tomwimmenhove/NoPullShit/cad/drawings/battery/ec0159ee7147ed0261.jpg

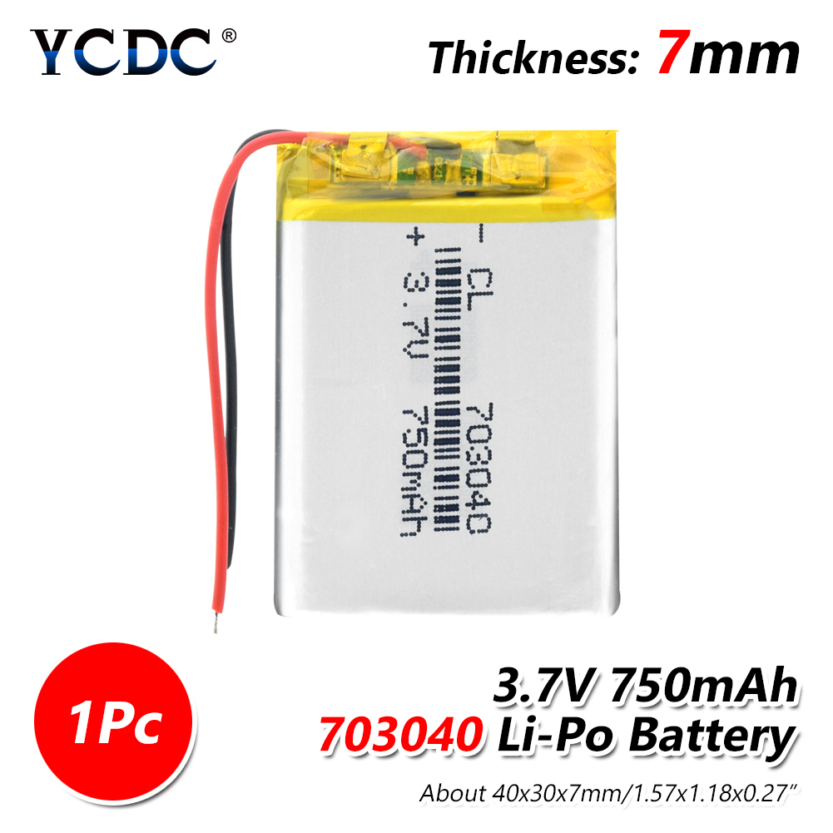
cad/drawings/battery/ec0159ee7147ed0261.jpg
