tomwimmenhove/NoPullShit/cad/drawings/speaker/s-l500.png

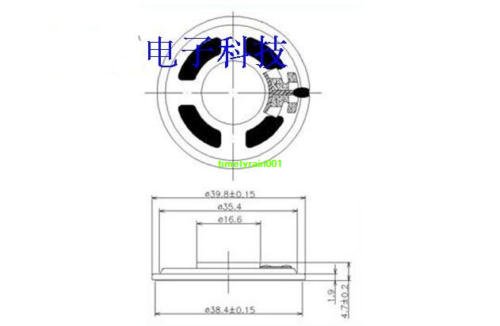
cad/drawings/speaker/s-l500.png
