tomwimmenhove/NoPullShit/cad/NoPullShit.FCStd

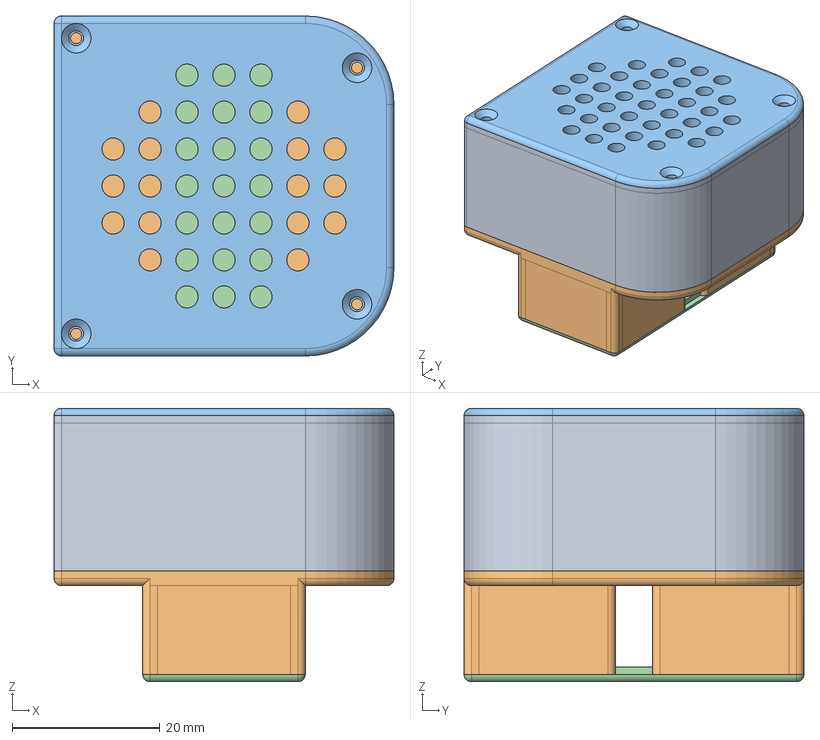
[picture p3: CAD file, 2021-06-24]
cad/NoPullShit.FCStd
46.0 x 46.0 x 37.0 mm
TopSection
BottomSection
TopCover
BottomCover
