tomwimmenhove/NoPullShit/cad/models/10103594-0001LF/10103594.stp

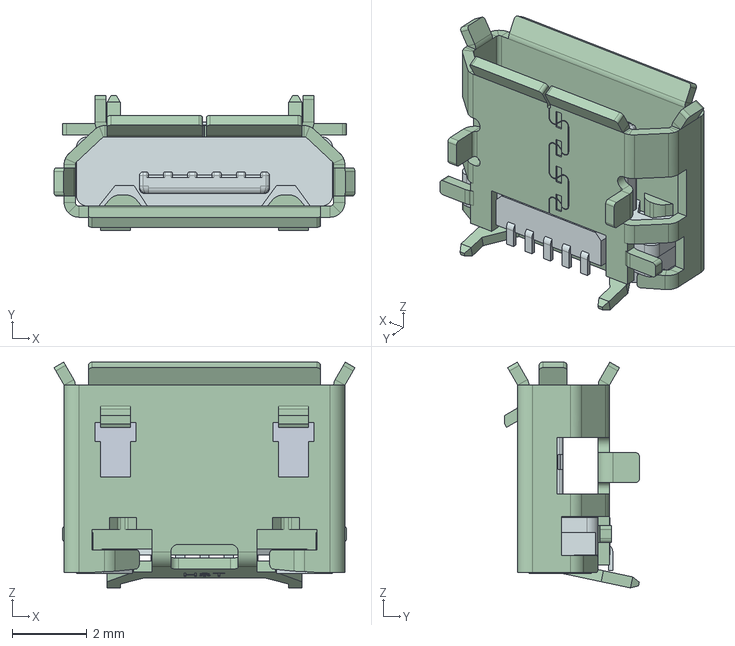
[picture p4: CAD file, 2021-06-19]
cad/models/10103594-0001LF/10103594.stp
8.04 x 3.60 x 6.03 mm
