tomwimmenhove/NoPullShit/hardware/NoPullShit/NoPullShit.kicad_pcb

## KiCad design hardware/NoPullShit/NoPullShit.kicad_pcb (2021-06-08)

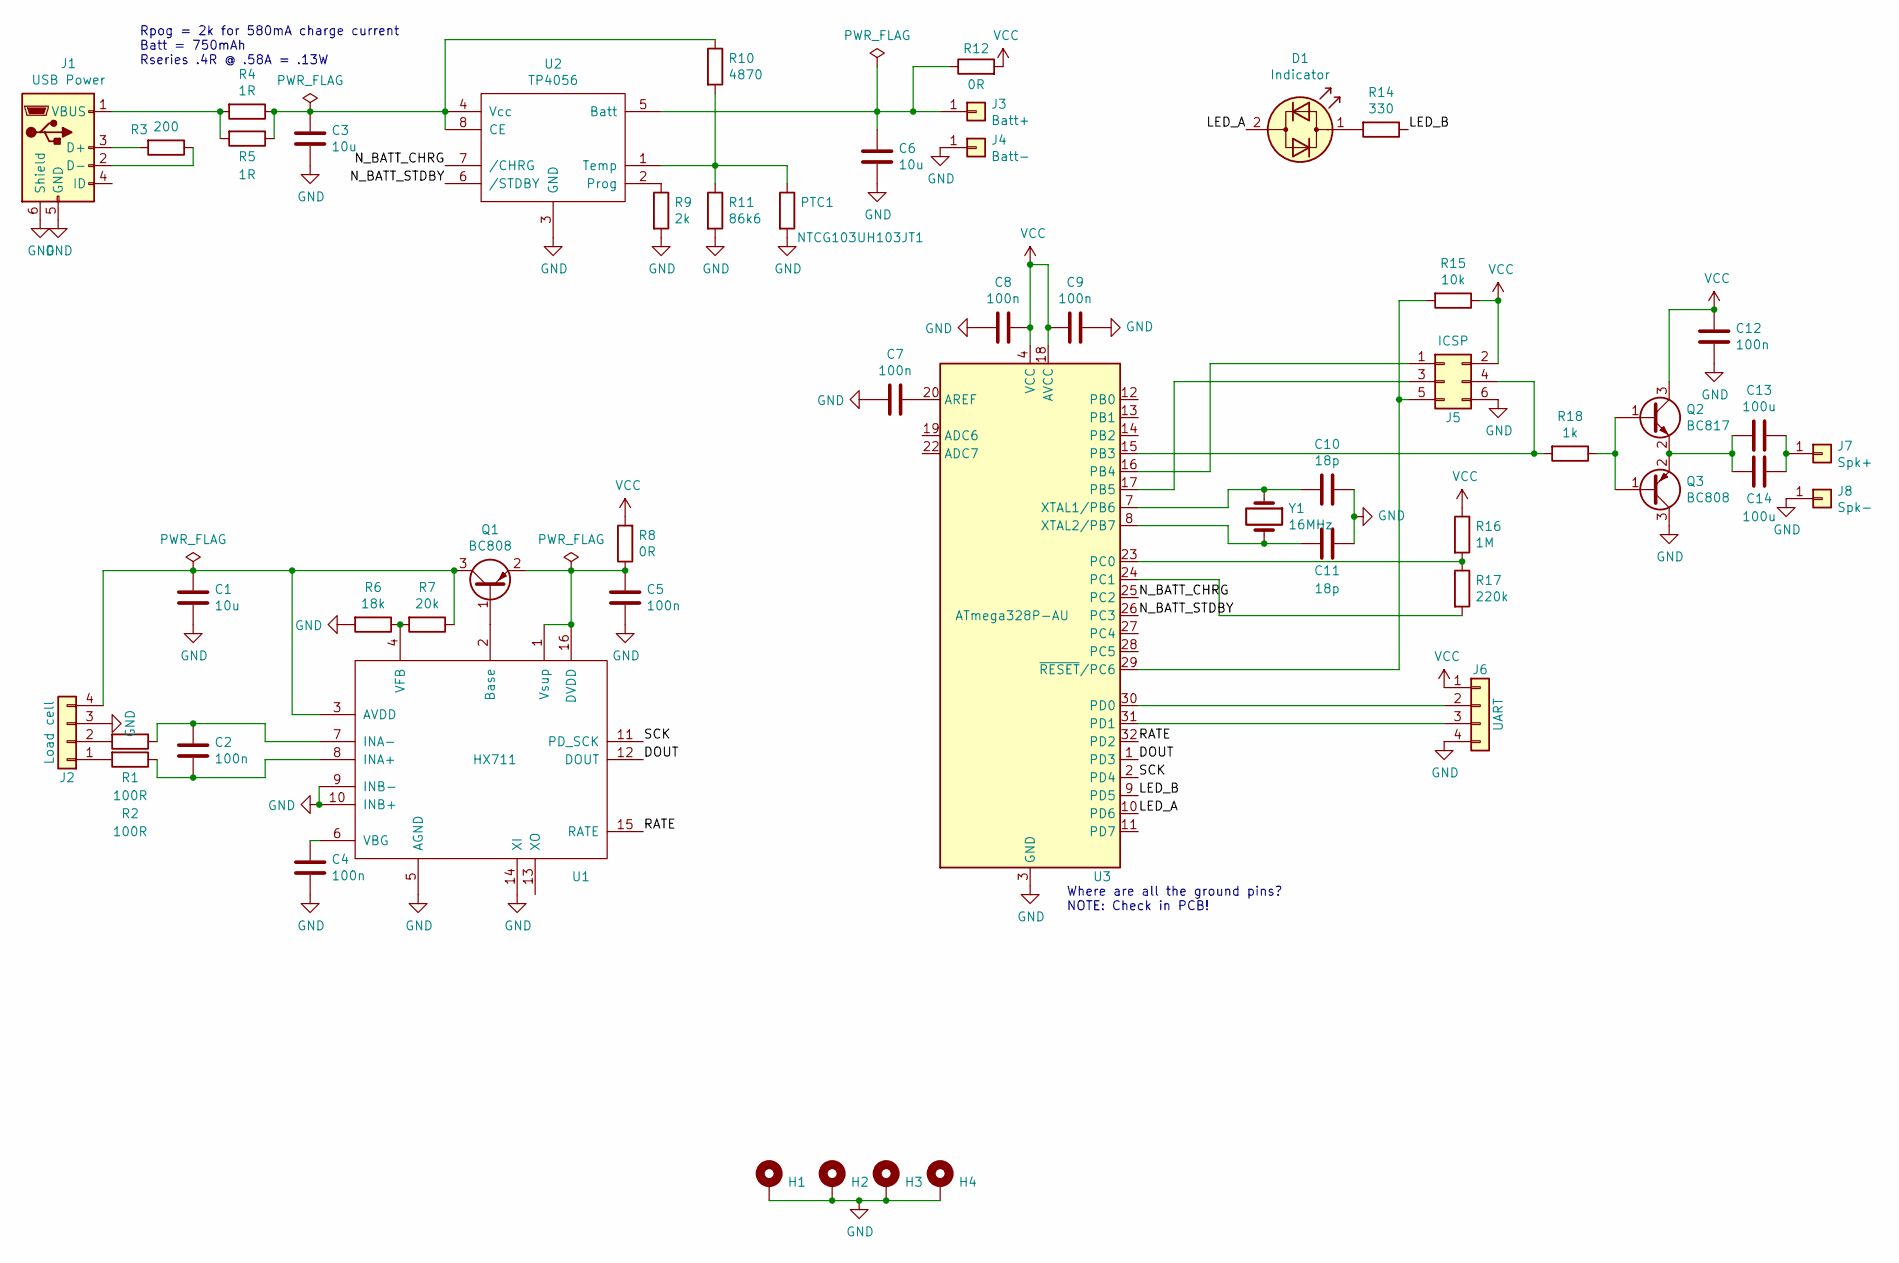
[picture p5: schematic NoPullShit.sch]

Parts:
C1, C3, C6: 10u; C_0805_2012Metric
C2, C4, C5, C7, C8, C9, C12: 100n; C_0603_1608Metric
C10, C11: 18p; C_0603_1608Metric
C13, C14: 100u; C_1206_3216Metric
D1: Indicator; LED_0603_1608Metric
H1, H2, H3, H4: MountingHole_Pad; MountingHole_2.2mm_M2_Pad_Via
J1: USB Power; USB_Micro-B_Amphenol_10103594-0001LF_Horizontal
J2: Load cell; PinHeader_1x04_P2.00mm_Vertical
J3: Batt+; TestPoint_THTPad_1.0x1.0mm_Drill0.5mm
J4: Batt-; TestPoint_THTPad_1.0x1.0mm_Drill0.5mm
J5: ICSP; PinHeader_2x03_P2.54mm_Vertical
J6: UART; PinHeader_1x04_P2.54mm_Vertical
J7: Spk+; TestPoint_THTPad_1.0x1.0mm_Drill0.5mm
J8: Spk-; TestPoint_THTPad_1.0x1.0mm_Drill0.5mm
PTC1: NTCG103UH103JT1; R_0603_1608Metric
Q1, Q3: BC808; SOT-23
Q2: BC817; SOT-23
R1, R2: 100R; R_0603_1608Metric
R3: 200; R_0603_1608Metric
R4, R5: 1R; R_0603_1608Metric
R6: 18k; R_0603_1608Metric
R7: 20k; R_0603_1608Metric
R8, R12: 0R; R_0603_1608Metric
R9: 2k; R_0603_1608Metric
R10: 4870; R_0603_1608Metric
R11: 86k6; R_0603_1608Metric
R14: 330; R_0603_1608Metric
R15: 10k; R_0603_1608Metric
R16: 1M; R_0603_1608Metric
R17: 220k; R_0603_1608Metric
R18: 1k; R_0603_1608Metric
U1: HX711; SOP-16_3.9x9.9mm_P1.27mm
U2: TP4056; SOP-8_3.9x4.9mm_P1.27mm
U3: ATmega328P-AU; TQFP-32_7x7mm_P0.8mm
Y1: 16MHz; Crystal_SMD_ECS_CSM3X-2Pin_7.6x4.1mm

Connections:
/DOUT: U1.12 (DOUT), U3.1 (PD3)
/LED_A: D1.2 (AK), U3.10 (PD6)
/LED_B: R14.1, U3.9 (PD5)
/N_BATT_CHRG: U2.7 (/CHRG), U3.25 (PC2)
/N_BATT_STDBY: U2.6 (/STDBY), U3.26 (PC3)
/RATE: U1.15 (RATE), U3.32 (PD2)
/SCK: U1.11 (PD_SCK), U3.2 (PD4)
GND: C1.2, C3.2, C4.1, C5.1, C6.2, C7.2, C8.2, C9.1, C10.1, C11.1, C12.1, H1.1, H2.1, H3.1, H4.1, J1.5 (GND), J1.6 (Shield), J2.3, J4.1, J5.6, J6.4, J8.1, PTC1.2, Q3.3 (C), R6.2, R9.2, R11.2, U1.5 (AGND), U1.9 (INB-), U1.10 (INB+), U1.14 (XI), U2.3 (GND), U3.3 (GND), U3.5 (GND), U3.21 (GND)
unnamed: C1.1, J2.4, Q1.3 (C), R7.1, U1.3 (AVDD)
unnamed: C2.1, R2.1, U1.8 (INA+)
unnamed: C2.2, R1.1, U1.7 (INA-)
unnamed: C3.1, R4.1, R5.1, R10.1, U2.4 (Vcc), U2.8 (CE)
unnamed: C4.2, U1.6 (VBG)
unnamed: C5.2, Q1.2 (E), R8.1, U1.1 (Vsup), U1.16 (DVDD)
unnamed: C6.1, J3.1, R12.1, U2.5 (Batt)
unnamed: C7.1, U3.20 (AREF)
unnamed: C10.2, U3.7 (XTAL1/PB6), Y1.1
unnamed: C11.2, U3.8 (XTAL2/PB7), Y1.2
unnamed: C13.1, C14.1, J7.1
unnamed: C13.2, C14.2, Q2.2 (E), Q3.2 (E)
unnamed: D1.1 (KA), R14.2
unnamed: J1.1 (VBUS), R4.2, R5.2
unnamed: J1.2 (D-), R3.1
unnamed: J1.3 (D+), R3.2
unnamed: J2.1, R2.2
unnamed: J2.2, R1.2
unnamed: J5.1, U3.16 (PB4)
unnamed: J5.3, U3.17 (PB5)
unnamed: J5.4, R18.2, U3.15 (PB3)
unnamed: J5.5, R15.2, U3.29 (~RESET~/PC6)
unnamed: J6.2, U3.30 (PD0)
unnamed: J6.3, U3.31 (PD1)
unnamed: PTC1.1, R10.2, R11.1, U2.1 (Temp)
unnamed: Q1.1 (B), U1.2 (Base)
unnamed: Q2.1 (B), Q3.1 (B), R18.1
unnamed: R6.1, R7.2, U1.4 (VFB)
unnamed: R9.1, U2.2 (Prog)
unnamed: R16.2, R17.1, U3.23 (PC0)
unnamed: R17.2, U3.24 (PC1)
VCC: C8.1, C9.2, C12.2, J5.2, J6.1, Q2.3 (C), R8.2, R12.2, R15.1, R16.1, U3.4 (VCC), U3.6 (VCC), U3.18 (AVCC)

Notes on the sheet:
Rpog = 2k for 580mA charge current Batt = 750mAh Rseries .4R @ .58A = .13W
Where are all the ground pins? NOTE: Check in PCB!

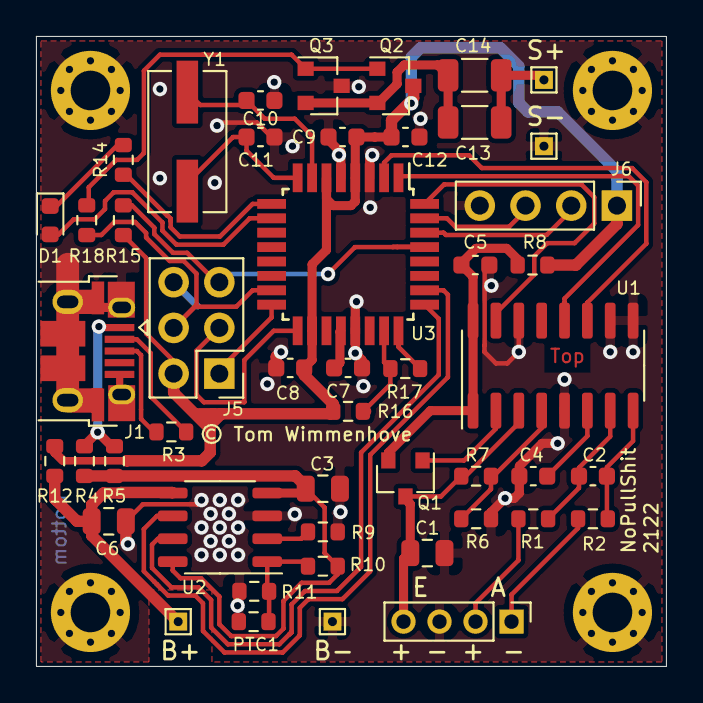
[picture p6: board NoPullShit.kicad_pcb from above]

Board: 2 copper layers, 35.0 x 35.0 mm, 52 parts (0 on the bottom side), 40 nets.
