tomwimmenhove/NoPullShit/(threads)

Thread 1 (2021-05-29):

Fix current usage in battery coma

tomwimmenhove, 2021-05-29:
