tomwimmenhove/NoPullShit/firmware/src/waves.cpp

/*
 * waves.cpp
 *
 *  Created on: Jun 14, 2021
 *      Author: Tom Wimmenhove
 */

#include "waves.h"

/*
 * Simple 750Hz sine wave
 */
const PROGMEM uint8_t wave_sine[] =
{
	0x7f, 0x88, 0x92, 0x9b, 0xa4, 0xad, 0xb6, 0xbf, 0xc7, 0xcf, 0xd6, 0xdc, 0xe3, 0xe8, 0xed, 0xf2,
	0xf5, 0xf8, 0xfb, 0xfc, 0xfd, 0xfe, 0xfd, 0xfc, 0xfa, 0xf7, 0xf4, 0xf0, 0xeb, 0xe6, 0xe0, 0xd9,
	0xd2, 0xcb, 0xc3, 0xbb, 0xb2, 0xa9, 0xa0, 0x96, 0x8d, 0x83, 0x7a, 0x70, 0x67, 0x5d, 0x54, 0x4b,
	0x42, 0x3a, 0x32, 0x2b, 0x24, 0x1d, 0x17, 0x12, 0x0d, 0x09, 0x06, 0x03, 0x01, 0x00, 0x00, 0x00,
	0x01, 0x02, 0x05, 0x08, 0x0b, 0x10, 0x15, 0x1a, 0x21, 0x27, 0x2e, 0x36, 0x3e, 0x47, 0x50, 0x59,
	0x62, 0x6b, 0x75,
};

/* 
 * Dog wave
 * f = 932Hz        
 * f * 1 @ -52.3dB
 * f * 2 @ -35.6dB
 * f * 3 @ -17.5dB
 * f * 4 @  -5.7dB
 * f * 5 @  -9.8dB
 * f * 6 @ -33.4dB
 */
const PROGMEM uint8_t wave_dog[] = 
{
	0x7f, 0xb1, 0xdb, 0xf6, 0xfd, 0xf1, 0xd3, 0xaa, 0x7d, 0x53, 0x34, 0x23, 0x22, 0x30, 0x48, 0x66,
	0x84, 0x9d, 0xae, 0xb5, 0xb2, 0xa7, 0x98, 0x88, 0x7a, 0x6f, 0x69, 0x67, 0x69, 0x6d, 0x72, 0x76,
	0x7a, 0x7d, 0x80, 0x83, 0x87, 0x8b, 0x90, 0x94, 0x96, 0x94, 0x8e, 0x83, 0x75, 0x65, 0x56, 0x4b,
	0x48, 0x4f, 0x60, 0x79, 0x97, 0xb5, 0xcd, 0xdb, 0xda, 0xc9, 0xaa, 0x80, 0x53, 0x2a, 0x0c, 0x00,
	0x07, 0x22, 0x4c,
};

const PROGMEM uint8_t wave_alert[] = {
	0x00, 0x00, 0x00, 0x00, 0x00, 0x00, 0x00, 0x00, 0x00, 0x00, 0x00, 0x00, 0x00, 0x00, 0x00, 0x00,
	0x00, 0x00, 0x00, 0x00, 0xff, 0xff, 0xff, 0xff, 0xff, 0xff, 0xff, 0xff, 0xff, 0xff, 0xff, 0xff,
	0xff, 0xff, 0xff, 0xff, 0xff, 0xff, 0xff, 0xff, };
