tomwimmenhove/NoPullShit/firmware/src/waves.h

/*
 * waves.h
 *
 *  Created on: Jun 14, 2021
 *      Author: Tom Wimmenhove
 */

#ifndef WAVES_H
#define WAVES_H

#include <avr/pgmspace.h>

extern const PROGMEM uint8_t wave_sine[83];
extern const PROGMEM uint8_t wave_dog[67];
extern const PROGMEM uint8_t wave_alert[40];

#endif /* WAVES_H */
