tomwimmenhove/NoPullShit/(commit log)

2021-05-27 Added speaker. Power saving. Standby. Etc
2021-05-27 Removed 'DC clicks' from audio. + Option to always set 80HZ measuring rate
2021-05-27 Better power saving in standby mode
2021-05-28 Disable interrupts while disabling BOD
2021-05-29 Fixed small power-drain bugs
    [config.h]
2021-05-29 Better way to turn off PWM
2021-05-29 Added battery monitoring
2021-05-30 Cheaper battery measurement
2021-05-30 Added power/lo-batt LED
2021-06-01 Added KiCad hardware project
    [NoPullShit.kicad_pcb, NoPullShit.sch]
2021-06-02 Footprint assignment + initial grouping
    [NoPullShit.sch]
2021-06-02 Initial routing backup
    [NoPullShit.kicad_pcb, NoPullShit.sch]
2021-06-02 Finished initla routing
    [NoPullShit.kicad_pcb, NoPullShit.sch]
2021-06-02 Fixed RefDes placement
    [NoPullShit.kicad_pcb]
2021-06-03 Small layout changes
    [NoPullShit.kicad_pcb, NoPullShit.sch]
2021-06-04 Small small changes
    [NoPullShit.kicad_pcb, NoPullShit.sch]
2021-06-05 More smaller, more better
    [NoPullShit.kicad_pcb, NoPullShit.sch]
2021-06-05 Tiny optimizations
    [NoPullShit.kicad_pcb]
2021-06-06 PSU current sense fix + some shuffling
    [NoPullShit.kicad_pcb, NoPullShit.sch]
2021-06-06 Better ground around x-tal
    [NoPullShit.kicad_pcb]
2021-06-06 Slightly improved ground-plane
    [NoPullShit.kicad_pcb]
2021-06-08 Hopefully ready for JLCPCB
    [NoPullShit.kicad_pcb]
2021-06-12 Minor audio cleanup and reset OCR2A when disabling audio
    [audio.cpp, audio.h, main.cpp]
2021-06-19 Added CAD models for PCB, Load cell, Battery and Speaker
    [10103594.stp, NoPullShit.FCStd]
2021-06-20 Freecad backup
    [NoPullShit.FCStd]
2021-06-20 Finished initial draft of case
    [NoPullShit.FCStd]
2021-06-20 Added screw supports and holes
    [NoPullShit.FCStd]
2021-06-20 Backup before FreeCAD fuckup
    [NoPullShit.FCStd]
2021-06-21 Fixed some chamfers/fillets and combined parts
    [NoPullShit.FCStd]
2021-06-21 Fillet load cell
    [NoPullShit.FCStd]
2021-06-21 Added battery drawing
2021-06-22 Fixed some normals
    [NoPullShit.FCStd]
2021-06-23 Added LED behind 200um window
    [NoPullShit.FCStd]
2021-06-23 Shit's round now!
    [NoPullShit.FCStd]
2021-06-23 Forgot to add bottom section without holes
    [NoPullShit.FCStd]
2021-06-24 Added charger indicators
2021-06-24 Changed screw placement and reinforced them
    [NoPullShit.FCStd]
2021-06-24 Added SLA STLs
    [BottomCover.stl, MainBody.stl, TopCover.stl]
2021-06-24 Backup before cleanup
    [NoPullShit.FCStd]
2021-06-24 Removed tons of old shit
    [BottomCover.stl, MainBody.stl, NoPullShit.FCStd, TopCover.stl]
2021-06-24 Fixed screw hole size
    [NoPullShit.FCStd]
2021-06-24 Also fixed screw hole size for PCB
    [NoPullShit.FCStd]
2021-06-24 Inverted ridges
    [NoPullShit.FCStd]
