tomwimmenhove/NoPullShit/(notices)

Notices in the files:
hardware/NoPullShit/NoPullShit.kicad_pcb:
© Tom Wimmenhove
